katonaaron/irrigation-station/README.md

# Automated irrigation station

A moisture level based plant irigation station with integrated webserver, hosting a RESTful API through which the clients can configure the application parameters.

For more details see [the documentation](doc/documentation.pdf)
