katonaaron/irrigation-station/doc/documentation.tex

%%%%%%%%%%%%%%%%%%%%%%%%%%%%%%%%%%%%%%%%%%%%%%%%%%%%%%%%%%%%%%%%%%%%%%%%%%%%%
%%%
%%% File: thesis.tex, version 1.9, May 2016
%%%
%%% =============================================
%%% This file contains a template that can be used with the package
%%% cs.sty and LaTeX2e to produce a thesis that meets the requirements
%%% of the Computer Science Department from the Technical University of Cluj-Napoca
%%%%%%%%%%%%%%%%%%%%%%%%%%%%%%%%%%%%%%%%%%%%%%%%%%%%%%%%%%%%%%%%%%%%%%%%%%%%%

\documentclass[12pt,a4paper,twoside]{report}     
\usepackage{cs}              
\usepackage{times}
\usepackage{graphicx}
\usepackage{latexsym}
\usepackage{amsmath,amsbsy}
\usepackage{amssymb}
\usepackage[matrix,arrow]{xy}
\usepackage[T1]{fontenc}
\usepackage{ae,aecompl}
%\usepackage{shortcut} %definitii pentru diacritice; 
\usepackage{amstext}
\usepackage{graphics}
\usepackage[T1]{fontenc}
\usepackage{ae,aecompl}
\usepackage{algorithm}
%\usepackage{algorithmic}
\usepackage{color}
\usepackage{color}
\usepackage{bytefield}
\usepackage{listings} 

\usepackage[hyphens]{url}
\usepackage[hidelinks]{hyperref}
\hypersetup{breaklinks=true}
\urlstyle{same}
\usepackage{cite}

% \mastersthesis
\diplomathesis
% \leftchapter
\centerchapter
% \rightchapter
\singlespace
% \oneandhalfspace
% \doublespace

\renewcommand{\thesisauthor}{Áron KATONA}    %% Your name.
\newcommand{\thesisauthorgroup}{30433}    %% Your group.
\renewcommand{\thesismonth}{}     %% Your month of graduation.
\renewcommand{\thesisyear}{2020}      %% Your year of graduation.
\renewcommand{\thesistitle}{Automated irrigation station with integrated RESTful web server} 
\renewcommand{\thesissupervisor}{}
\newcommand{\department}{\bf FACULTY OF AUTOMATION AND COMPUTER SCIENCE\\
COMPUTER SCIENCE DEPARTMENT}
\newcommand{\thesis}{}
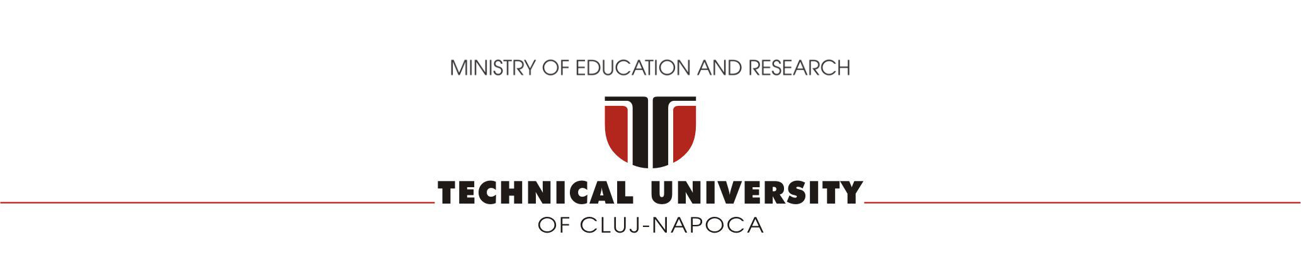
[picture p7: doc/img/tucn.jpg]
\newcommand{\utcnlogo}{}

\newcommand{\uline}[1]{\rule[0pt]{#1}{0.4pt}}
%\renewcommand{\thesisdedication}{P\u{a}rin\c{t}ilor mei}

\begin{document}
%\frontmatter
%\pagestyle{headings}

\newenvironment{definition}[1][Defini\c{t}ie.]{\begin{trivlist}
\item[\hskip \labelsep {\bfseries #1}]}{\end{trivlist}}

%\thesistitle                    %% Generate the title page.
%\authordeclarationpage                %% Generate the declaration page.

\begin{center}
\utcnlogo

\department

\vspace{4cm}

{\bf \thesistitle} %LICENSE THESIS TITLE}

\vspace{1.5cm}

\vspace{6cm}

Name: {\bf \thesisauthor} 

Group: {\bf \thesisauthorgroup}

\vspace{1cm}

https://github.com/katonaaron/irrigation-station

\vspace{2cm}
{\bf \thesisyear}
\end{center}

\thispagestyle{empty}
\newpage

\pagenumbering{roman}
\setcounter{page}{1}

\tableofcontents
\newpage

\pagenumbering{arabic}
\setcounter{page}{1}
\pagestyle{headings}

\input{tex/introduction}
\input{tex/biblographic_research}
\input{tex/implementation}
\input{tex/validation}
\input{tex/conclusion}

\Urlmuskip=0mu plus 1mu
%\addcontentsline {toc}{chapter}{Bibliography} 
\bibliographystyle{IEEEtran} 
\bibliography{documentation}%same file name as for .bib

\end{document}
