katonaaron/irrigation-station/(list of files, drawings)

Other design files:
doc/img/IrrigationStationHardware.fzz
