katonaaron/irrigation-station/(commit log)

2020-12-14 Implement soil moisture sensor, interrupt and EEPROM functions
2020-12-16 Add 2 seven segment displays. In a normal state it shows the setup code or the moisture percentage. In case of an error it shows an error code
    [config.h, controller.ino, display.ino, error.h, processing.ino, wifi.ino]
2021-01-13 Add documentation
    [IrrigationStationHardware.fzz]
